austin207/32-bit-Tiny-GPU/assets/PDFs/Core.pdf

Core Module Architecture-level core datapath — SIMT GPU core with replicated thread lanes

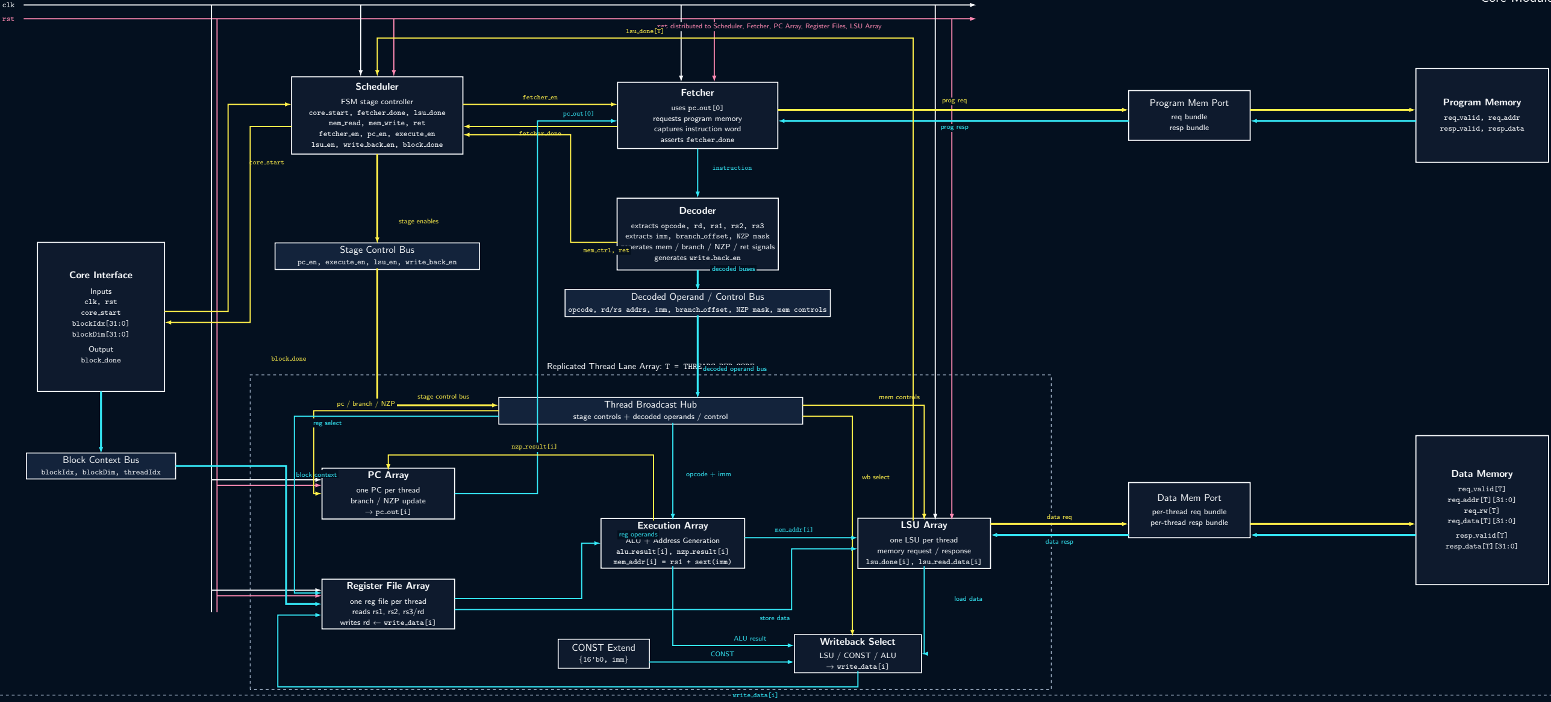
[picture p6: figure]
Core Interface; Inputs; clk, rst; core start; blockIdx[31:0]; blockDim[31:0]; Output; block done; Block Context Bus; blockIdx, blockDim, threadIdx; Program Memory; req valid, req addr; resp valid, resp data; Data Memory; req valid[T]; req addr[T][31:0]; req rw[T]; req data[T][31:0]; resp valid[T]; resp data[T][31:0]; Program Mem Port; req bundle; resp bundle; Data Mem Port; per-thread req bundle; per-thread resp bundle; Scheduler; FSM stage controller; core start, fetcher done, lsu done; mem read, mem write, ret; fetcher en, pc en, execute en; lsu en, write back en, block done; Fetcher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

generates mem / branch / NZP / ret signals

pc en, execute en, lsu en, write back en

opcode, rd/rs addrs, imm, branch offset, NZP mask, mem controls

### Replicated Thread Lane Array: T = THREADS PER CORE

stage controls + decoded operands / control rst distributed to Scheduler, Fetcher, PC Array, Register Files, LSU Array
