austin207/32-bit-Tiny-GPU/assets/PDFs/Memory Controller.pdf

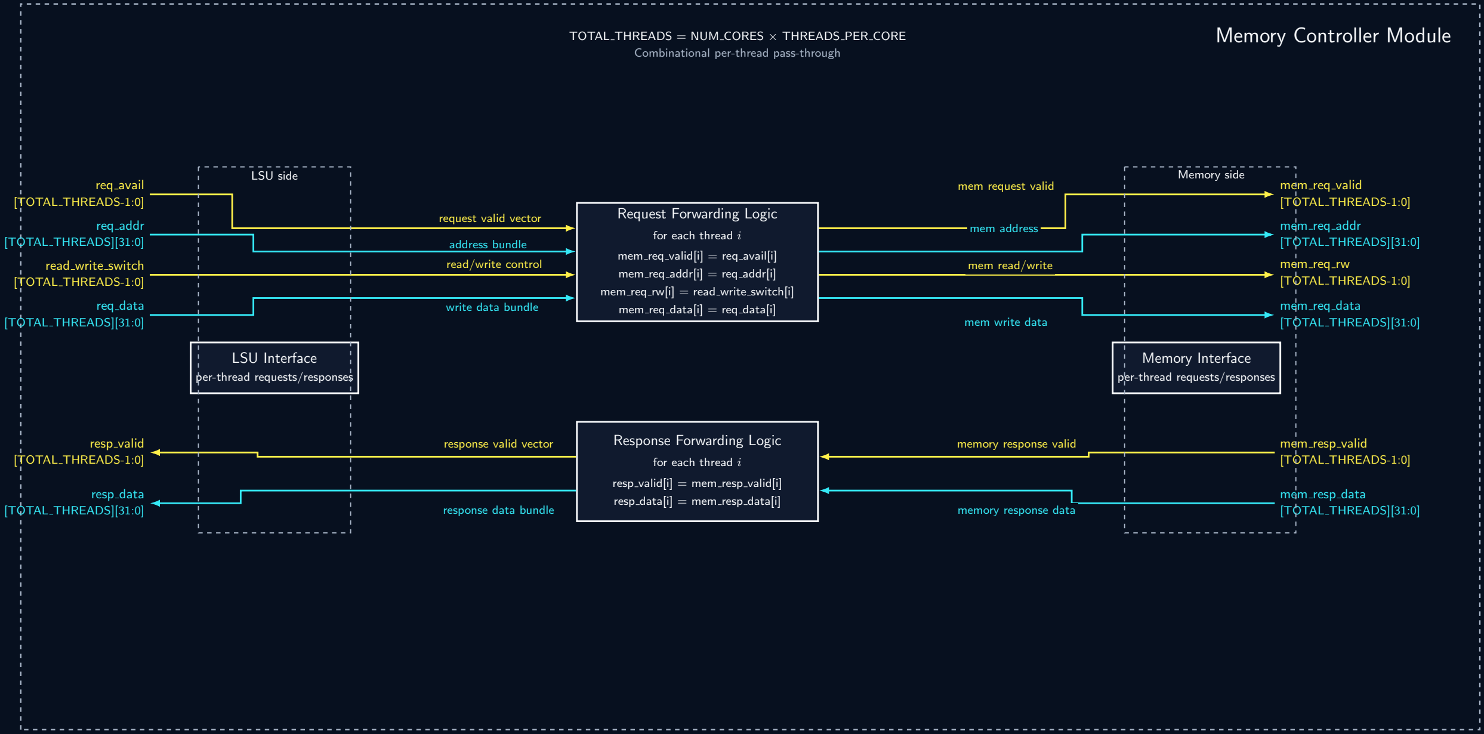
[picture p7: figure]
Combinational per-thread pass-through; Request Forwarding Logic; for each thread i; mem req valid[i] = req avail[i]; mem req addr[i] = req addr[i]; mem req rw[i] = read write switch[i]; mem req data[i] = req data[i]; Response Forwarding Logic; resp valid[i] = mem resp valid[i]; resp data[i] = mem resp data[i]; LSU Interface; per-thread requests/responses; Memory Interface; req avail; [TOTAL THREADS-1:0]; req addr; [TOTAL THREADS][31:0]; read write switch; req data; resp valid; resp data; mem req valid; mem req addr; mem req rw; mem req data; mem resp valid; mem resp data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

TOTAL THREADS = NUM CORES × THREADS PER CORE | Memory Controller Module
