austin207/32-bit-Tiny-GPU/assets/PDFs/DCR.pdf

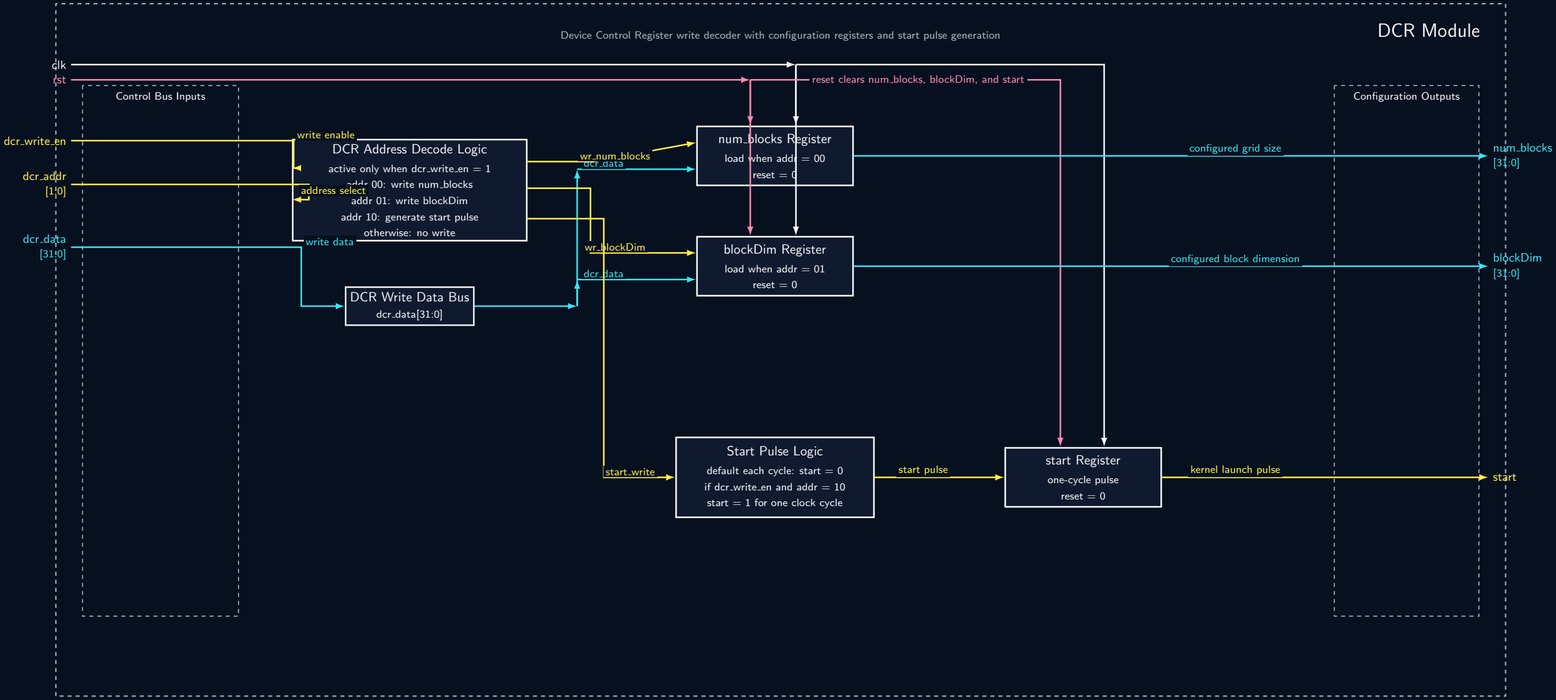
[picture p15: figure]
Control Bus Inputs; Configuration Outputs; clk rst; dcr write en; dcr addr; dcr data; num blocks; blockDim; start; DCR Address Decode Logic; active only when dcr write en = 1; addr 00: write num blocks; addr 01: write blockDim; addr 10: generate start pulse; otherwise: no write; DCR Write Data Bus; dcr data[31:0]; num blocks Register; load when addr = 00; reset = 0; blockDim Register; load when addr = 01; Start Pulse Logic; default each cycle: start = 0; if dcr write en and addr = 10; start = 1 for one clock cycle; start Register; one-cycle pulse; write enable; address select; write data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

Device Control Register write decoder with configuration registers and start pulse generation | DCR Module

reset clears num blocks, blockDim, and start
