austin207/32-bit-Tiny-GPU/assets/PDFs/Dispatcher.pdf

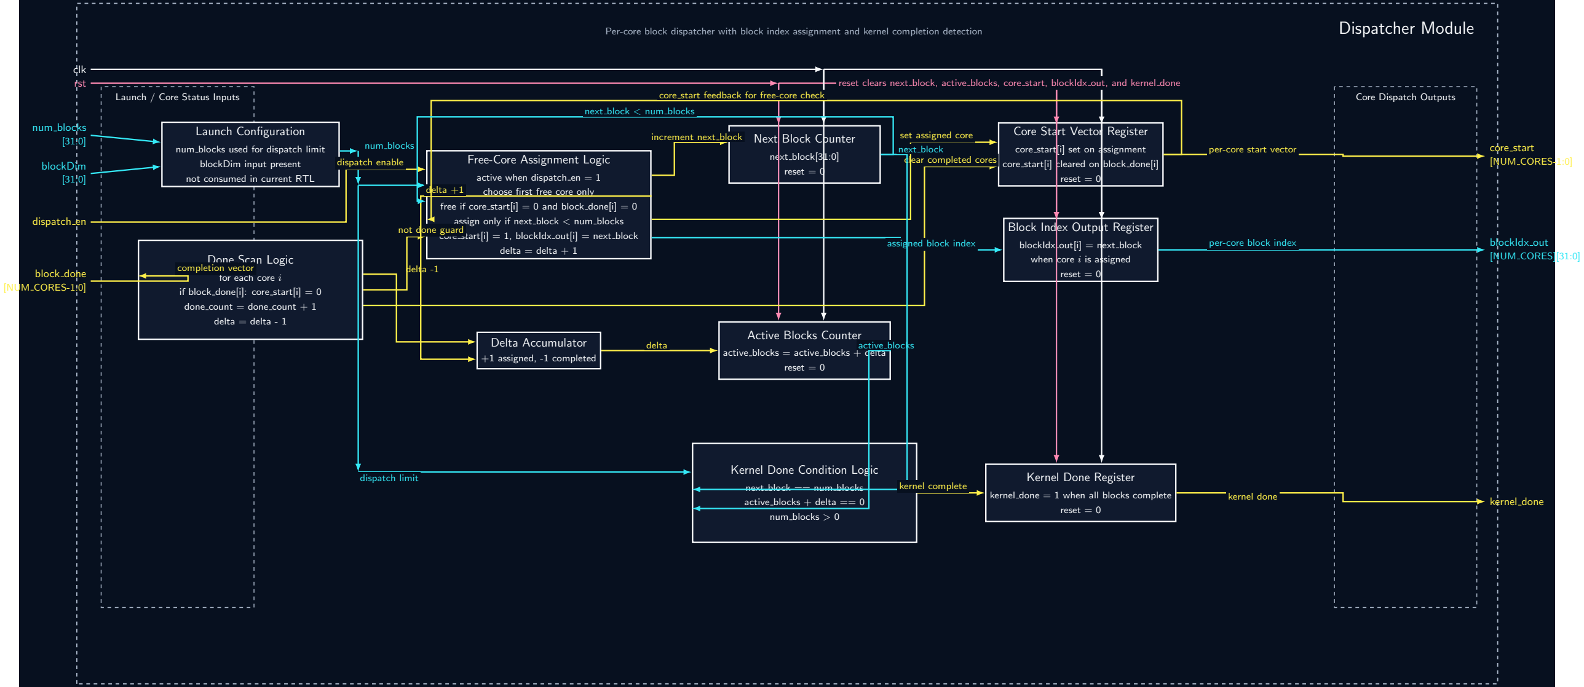
[picture p16: figure]
Launch / Core Status Inputs; Core Dispatch Outputs; clk rst; num blocks; blockDim; dispatch en; block done; [NUM CORES-1:0]; core start; blockIdx out; [NUM CORES][31:0]; kernel done; Launch Configuration; num blocks used for dispatch limit; blockDim input present; not consumed in current RTL; Done Scan Logic; for each core i; if block done[i]: core start[i] = 0; done count = done count + 1; delta = delta - 1; Free-Core Assignment Logic; active when dispatch en = 1; choose first free core only; assign only if next block < num blocks; delta = delta + 1; Delta Accumulator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

Per-core block dispatcher with block index assignment and kernel completion detection | Dispatcher Module

free if core start[i] = 0 and block done[i] = 0

core start[i] = 1, blockIdx out[i] = next block

kernel done = 1 when all blocks complete reset clears next block, active blocks, core start, blockIdx out, and kernel done
