austin207/32-bit-Tiny-GPU/assets/PDFs/Fetcher.pdf

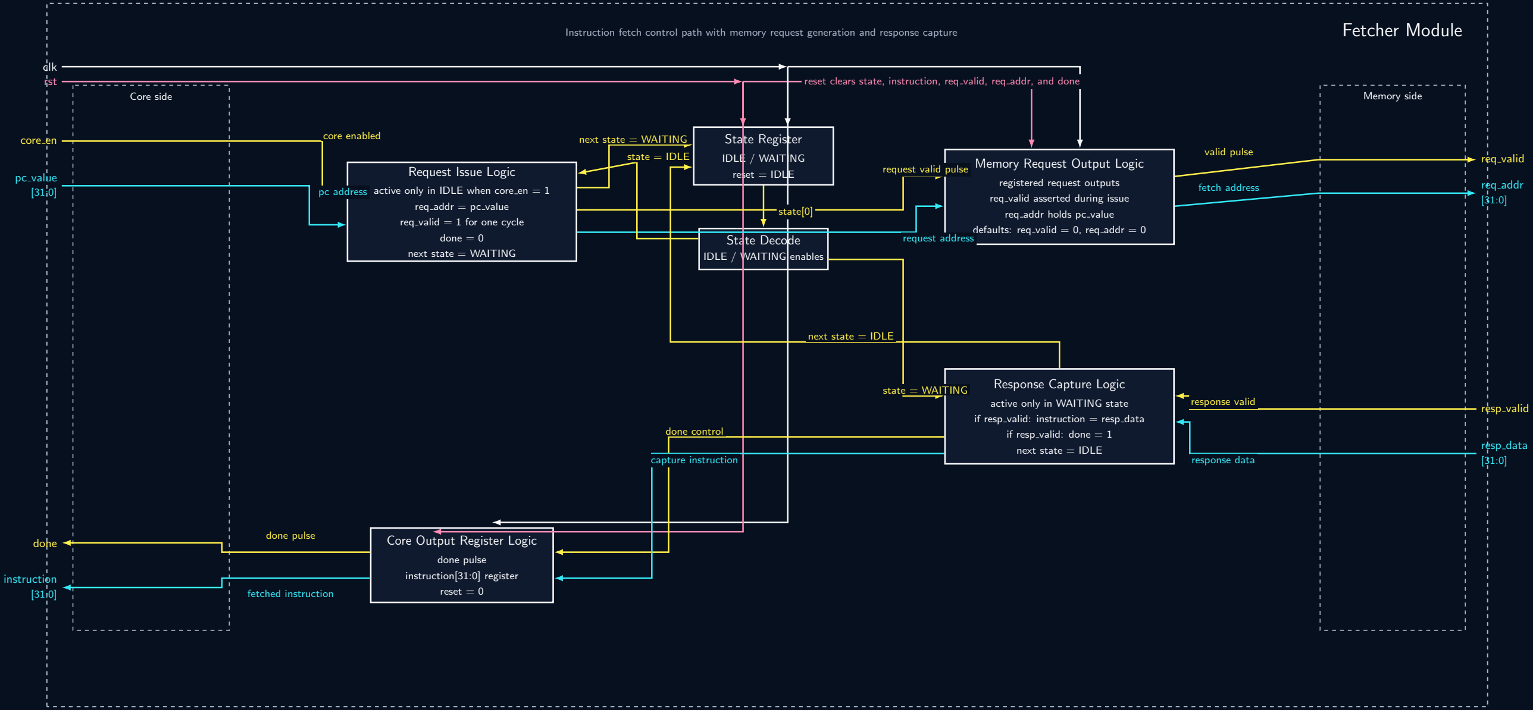
[picture p17: figure]
Core side; Memory side; clk rst; core en; pc value; done; instruction; req valid; req addr; resp valid; resp data; active only in IDLE when core en = 1; State Register; IDLE / WAITING; reset = IDLE; State Decode; enables; Memory Request Output Logic; registered request outputs; req valid asserted during issue; req addr holds pc value; defaults: req valid; = 0, req addr = 0; Response Capture Logic; active only in WAITING state; if resp valid: instruction = resp data; if resp valid: done = 1; next state = IDLE; Core Output Register Logic; done pulse; instruction[31:0] register; reset = 0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

Instruction fetch control path with memory request generation and response capture | Fetcher Module
Request Issue Logic req addr = pc value req valid next state = WAITING | = 1 for one done = 0 | cycle

reset clears state, instruction, req valid, req addr, and done
