austin207/32-bit-Tiny-GPU/assets/PDFs/GPU.pdf

GPU Module Top-level: NUM CORES=4, THREADS PER CORE=4, TOTAL THREADS=16

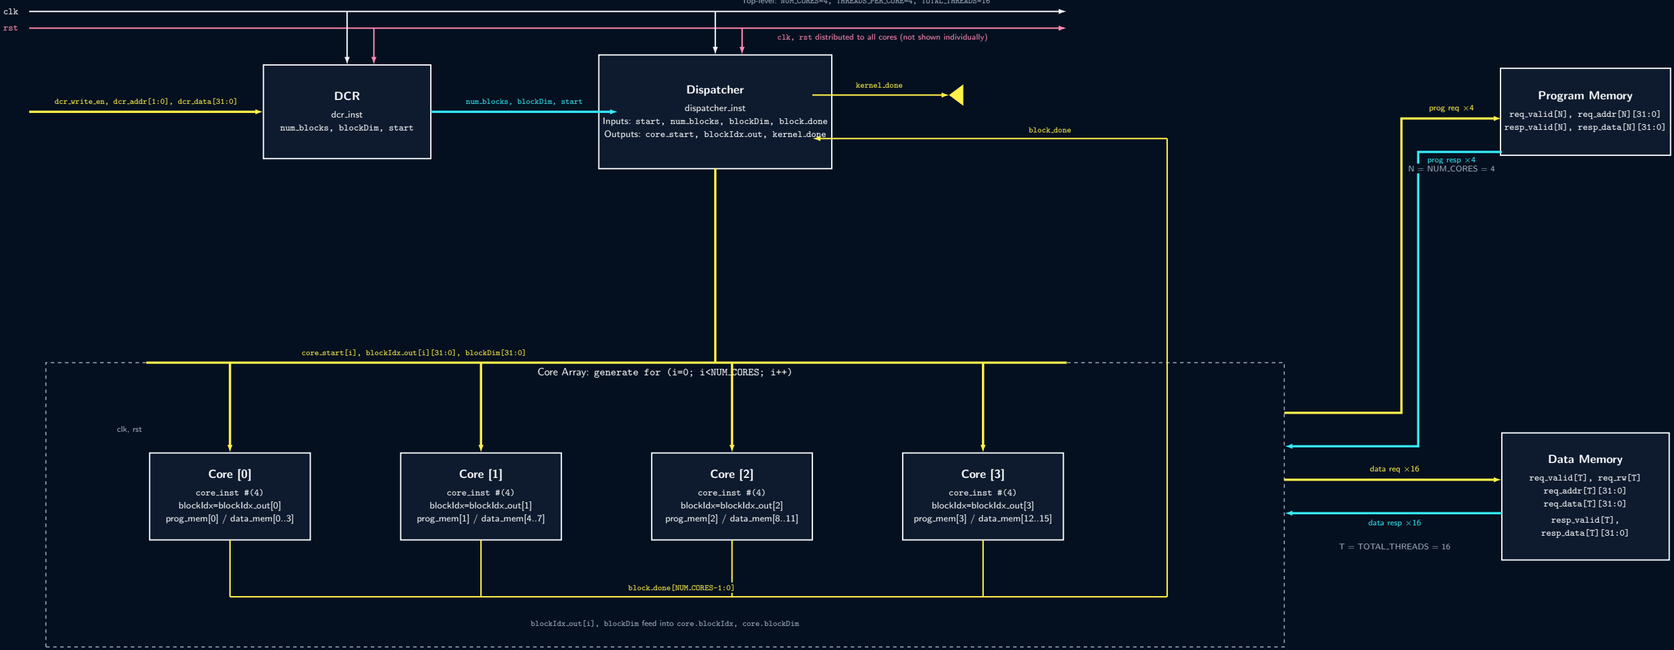
[picture p18: figure]
DCR; dcr inst; num blocks, blockDim, start; Dispatcher; dispatcher inst; Program Memory; req valid[N], req addr[N][31:0]; resp valid[N], resp data[N][31:0]; Data Memory; req valid[T], req rw[T]; req addr[T][31:0]; req data[T][31:0]; resp valid[T],; resp data[T][31:0]; Core [0]; core inst #(4); blockIdx=blockIdx out[0]; prog mem[0] / data mem[0..3]; Core [1]; blockIdx=blockIdx out[1]; prog mem[1] / data mem[4..7]; Core [2]; blockIdx=blockIdx out[2]; prog mem[2] / data mem[8..11]; Core [3]; blockIdx=blockIdx out[3]; prog mem[3] / data mem[12..15]; clk; rst; kernel done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

Inputs: start, num blocks, blockDim, block done Outputs: core start, blockIdx out, kernel done

### Core Array: generate for (i=0; i<NUM CORES; i++)

clk, rst distributed to all cores (not shown individually)

dcr write en, dcr addr[1:0], dcr data[31:0] | num blocks, blockDim, start

blockIdx out[i], blockDim feed into core.blockIdx, core.blockDim
