austin207/32-bit-Tiny-GPU/assets/PDFs/LSU.pdf

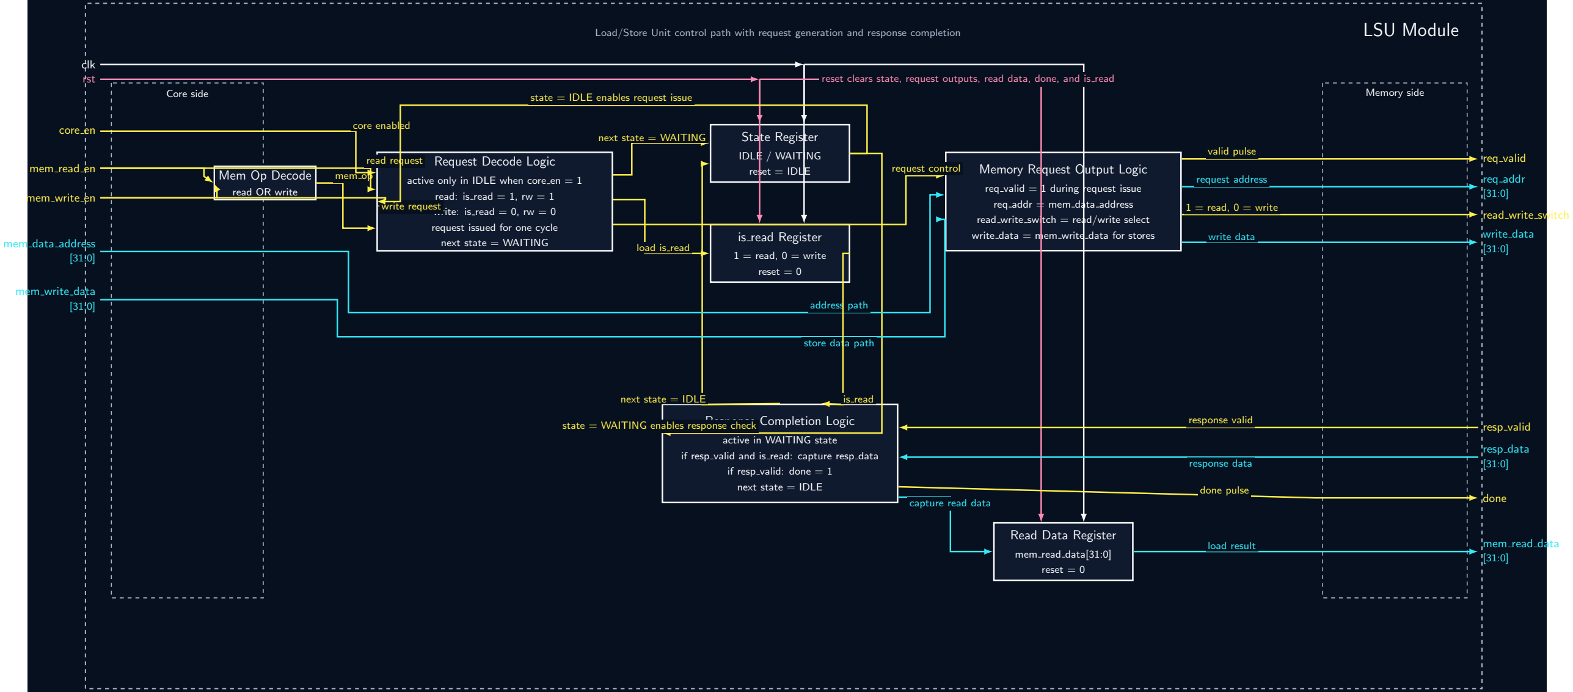
[picture p19: figure]
Core side; Memory side; clk rst; core en; mem read en; mem write en; mem data address; mem write data; req valid; req addr; read write switch; write data; resp valid; resp data; done; mem read data; Mem Op Decode; read OR write; Request Decode Logic; active only in IDLE when core en = 1; read: is read = 1, rw = 1; write: is read = 0, rw = 0; request issued for one cycle; next state = WAITING; State Register; IDLE / WAITING; reset = IDLE; is read Register; 1 = read, 0 = write; reset = 0; Memory Request Output Logic; req valid = 1 during request issue; req addr = mem data address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

Load/Store Unit control path with request generation and response completion | LSU Module

if resp valid and is read: capture resp data reset clears state, request outputs, read data, done, and is read
