austin207/32-bit-Tiny-GPU/assets/PDFs/PC.pdf

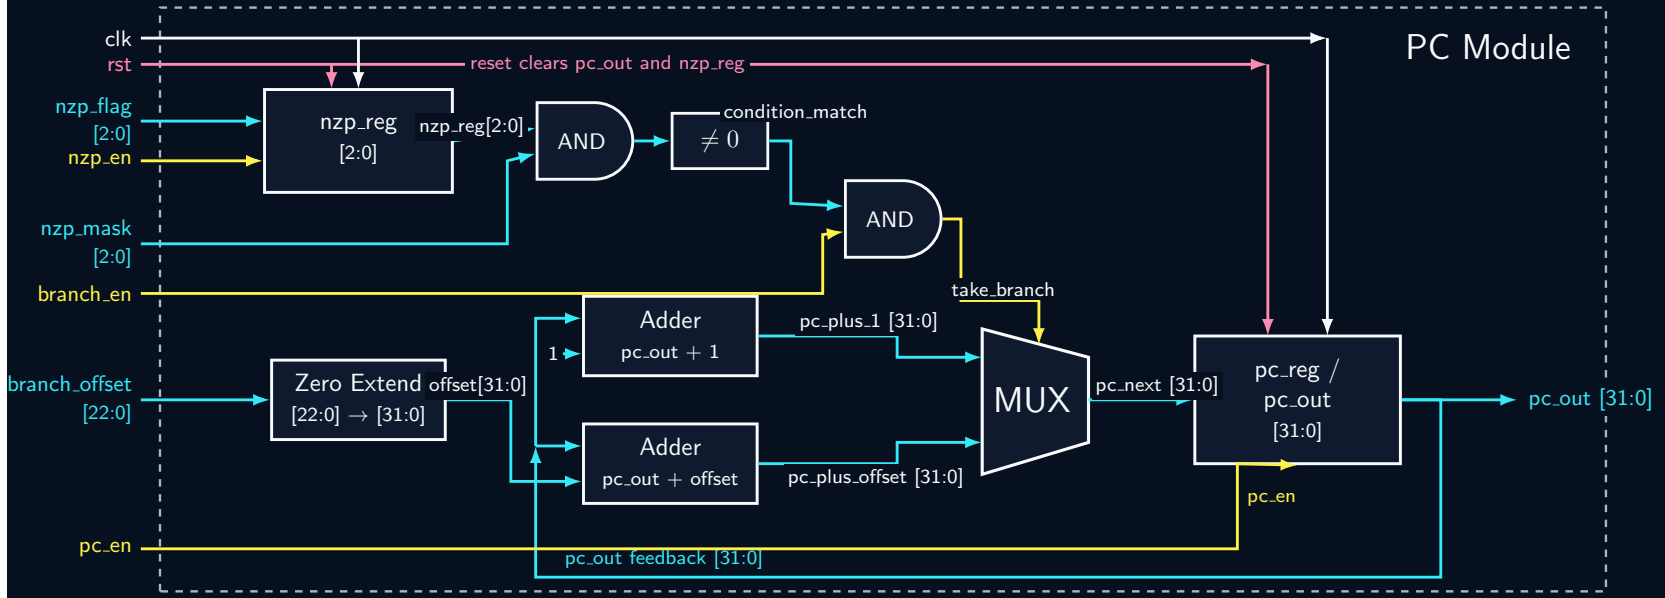
[picture p20: figure]
PC Module clk rst; nzp flag; [2:0] nzp en; nzp mask; branch en; branch offset; nzp reg; AND; Zero Extend; Adder; pc out + 1; pc out + offset; pc reg / pc out; MUX; reset clears pc out and nzp reg; nzp; reg[2:0]; condition match; take branch; offset[31:0]; pc out feedback [31:0]; pc plus 1 [31:0]; pc plus offset [31:0]; pc next [31:0]; pc out [31:0]
