austin207/32-bit-Tiny-GPU/assets/PDFs/Register.pdf

# Registers Module

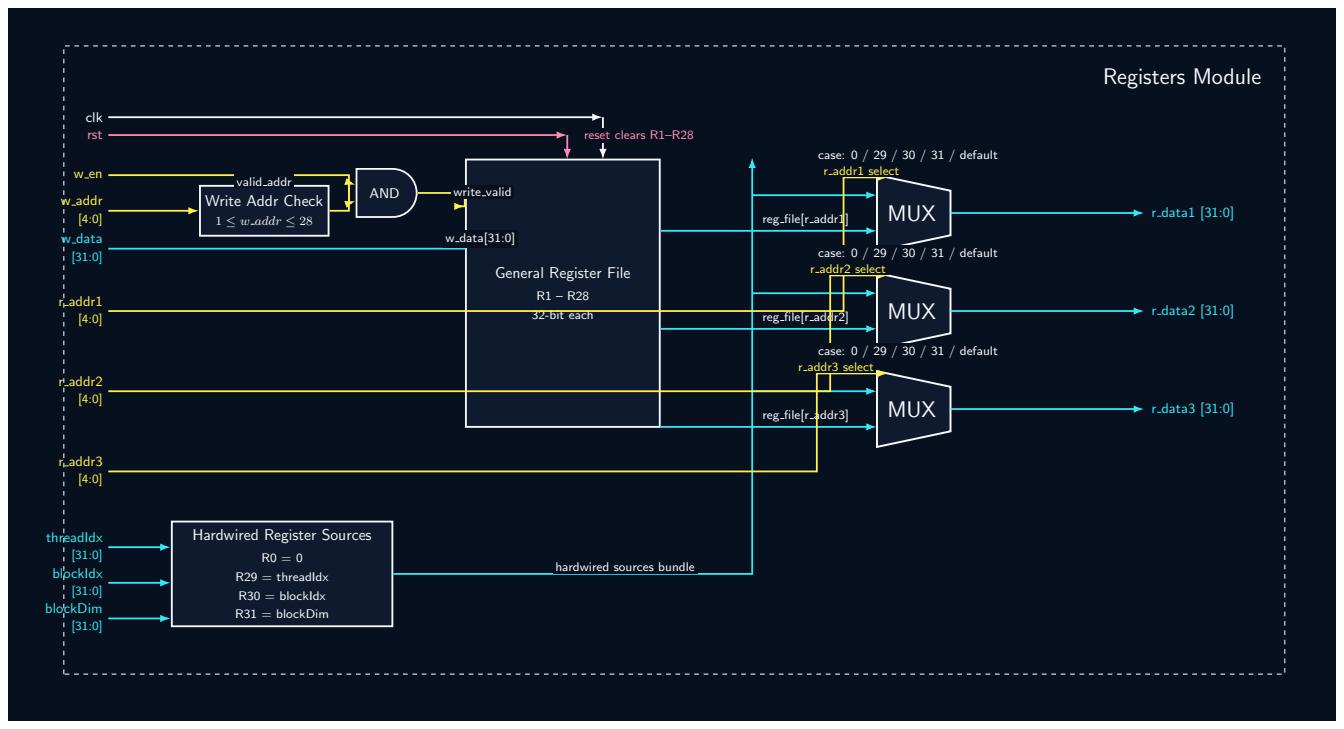
[picture p21: page 1]
clk rst; w addr; w data; addr1; addr2; addr3; threadIdx; [31:0] blockIdx; [31:0] blockDim; AND; R29 = threadIdx; R30 = blockIdx; R31 = blockDim; MUX; reset clears R1–R28; write valid; reg file[r addr1]; reg file[r addr3]; r addr1 select; r addr2 select; r addr3 select; case: 0 / 29 / 30 / 31 / default; r data1 [31:0]; r data2 [31:0]; r data3 [31:0]

valid addr
Write Addr Check
1 ≤ w addr ≤ 28

w data[31:0]

case: 0 / 29 / 30 / 31 / default

General Register File

R1 – R28
32-bit each | reg file[r addr2]

Hardwired Register Sources

hardwired sources bundle
