austin207/32-bit-Tiny-GPU/assets/PDFs/Scheduler.pdf

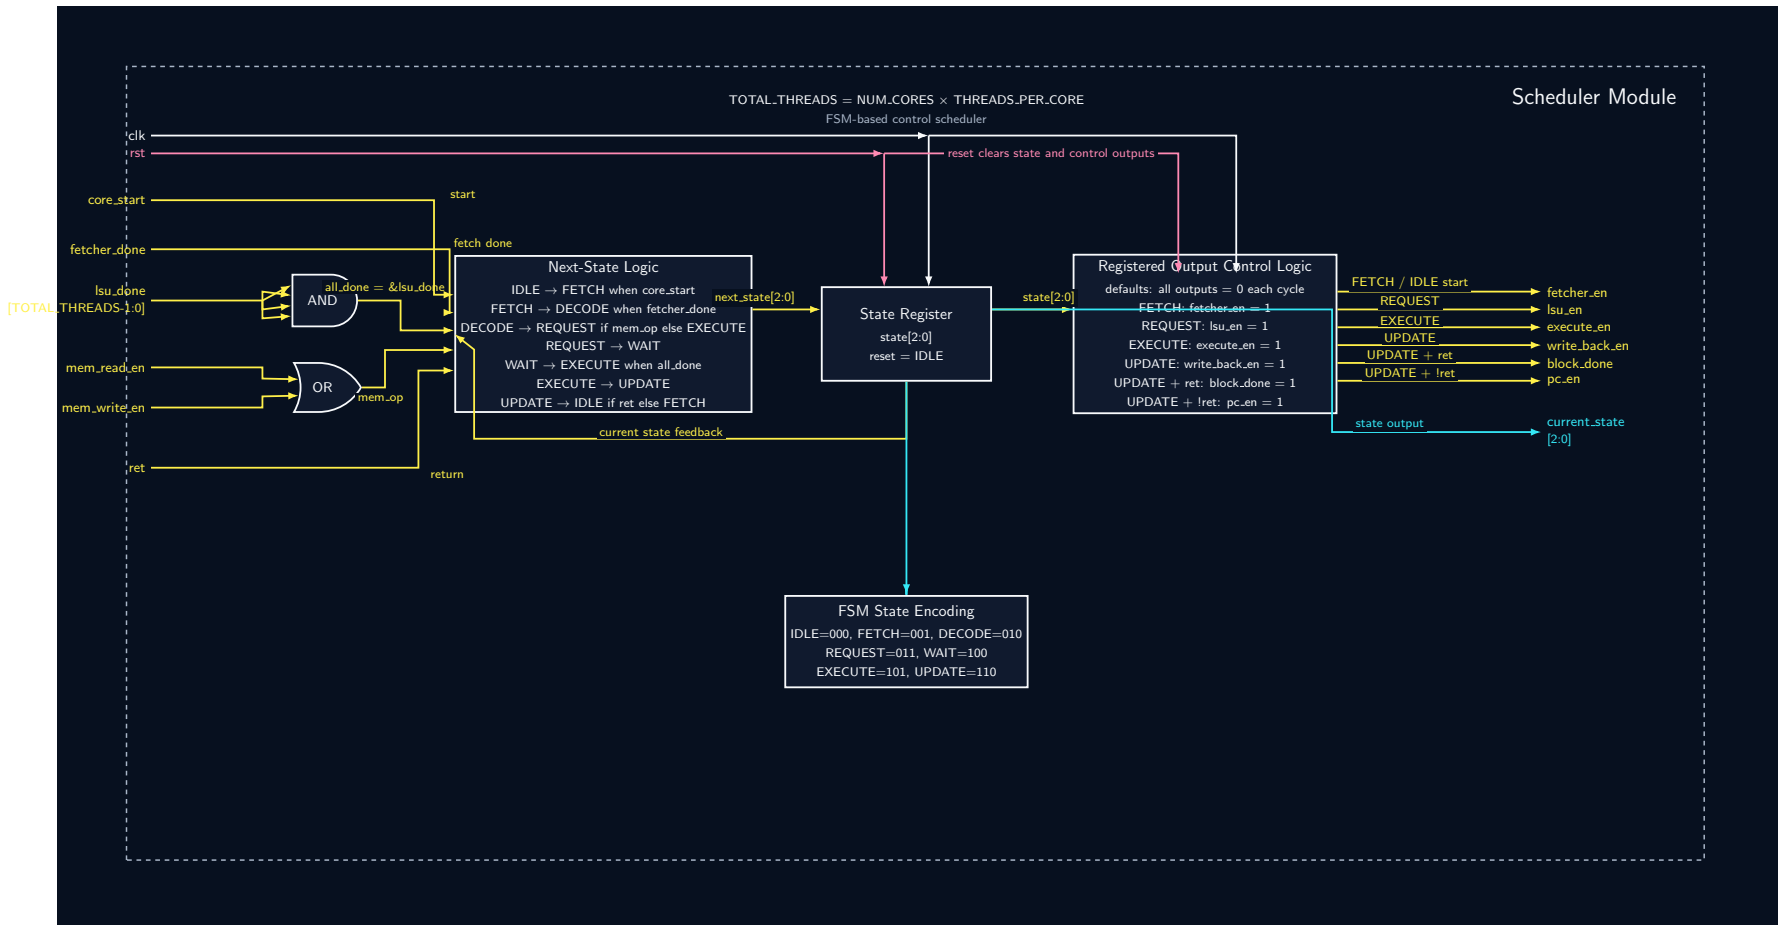
[picture p22: page 1]
TOTAL THREADS = NUM CORES × THREADS PER CORE; Scheduler Module; clk rst; core start; fetcher done; lsu done; [TOTAL THREADS-1:0]; mem read; mem write; ret; REQUEST → WAIT; State Register; state[2:0]; reset = IDLE; REQUEST=011, WAIT=100; EXECUTE=101, UPDATE=110; current state; mem op; start; fetch done; return; next state[2:0]; state output

FSM-based control scheduler

reset clears state and control outputs

Next-State Logic

Registered Output Control Logic

all done = &lsu done
AND

FETCH / IDLE start
REQUEST
EXECUTE
UPDATE
UPDATE + ret
UPDATE + !ret

IDLE → FETCH when core start
FETCH → DECODE when fetcher done
DECODE → REQUEST if mem op else EXECUTE

defaults: all outputs = 0 each cycle

fetcher en
lsu en
execute en
write back en
block done

FETCH: fetcher en = 1
REQUEST: lsu en = 1
EXECUTE: execute en = 1
UPDATE: write back en = 1
UPDATE + ret: block done = 1
UPDATE + !ret: pc en = 1

WAIT → EXECUTE when all done
EXECUTE → UPDATE

UPDATE → IDLE if ret else FETCH

current state feedback

FSM State Encoding

IDLE=000, FETCH=001, DECODE=010
