austin207/32-bit-Tiny-GPU/assets/PDFs/warp_stack.pdf

clk | warp stack Module

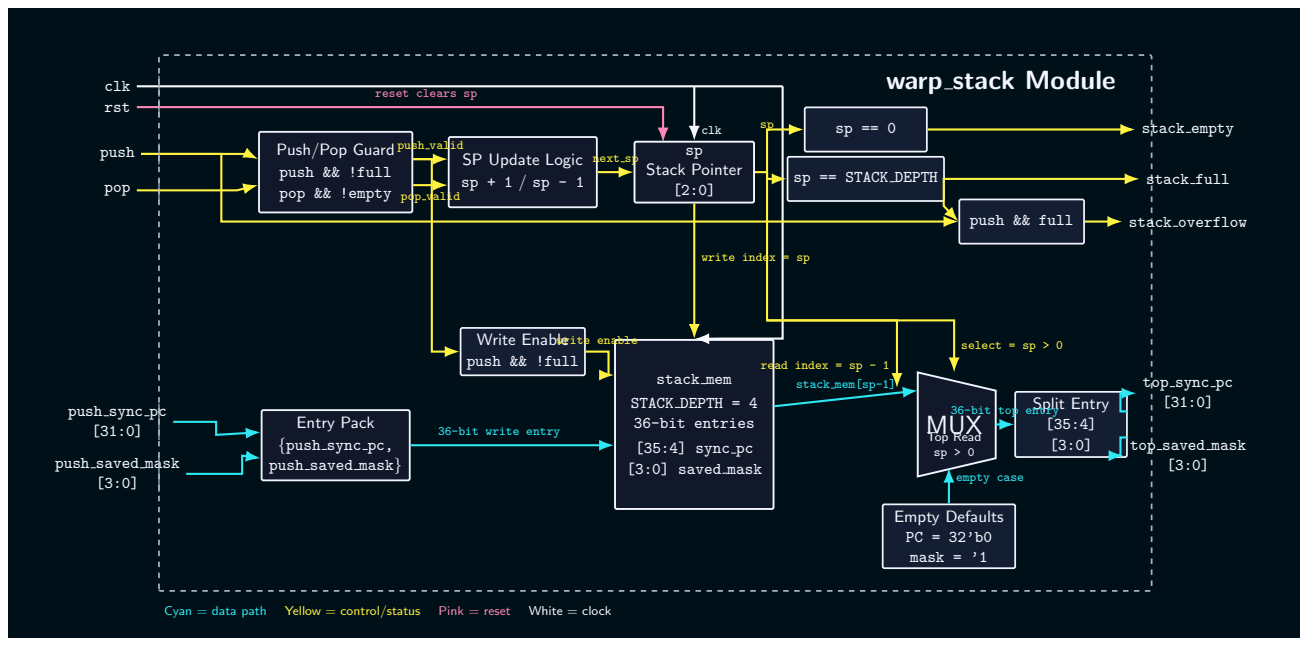
[picture p23: page 1]
rst; push; pop; sp Stack Pointer [2:0]; push && full; Write Enable; push && !full; stack mem; STACK DEPTH = 4 36-bit entries; [35:4] sync pc [3:0] saved mask; Empty Defaults; PC = 32’b0 mask = ’1; Split Entry [35:4] [3:0]; stack empty; stack full; stack overflow; clk; push valid; pop valid; next sp; write enable; select = sp > 0; empty case; Cyan = data path; Yellow = control/status; Pink = reset; White = clock

reset clears sp

Push/Pop Guard
push && !full
pop && !empty

SP Update Logic

sp == STACK DEPTH

write index = sp

read index = sp - 1

top sync pc

stack mem[sp-1]

push sync pc

36-bit top entry
MUX Top Read

Entry Pack
{push sync pc,
push saved mask}

36-bit write entry

top saved mask

push saved mask
