austin207/32-bit-Tiny-GPU/assets/PDFs/ALU.pdf

## 6’h01 ADD op1 + op2

## 6’h02 SUB op1 - op2

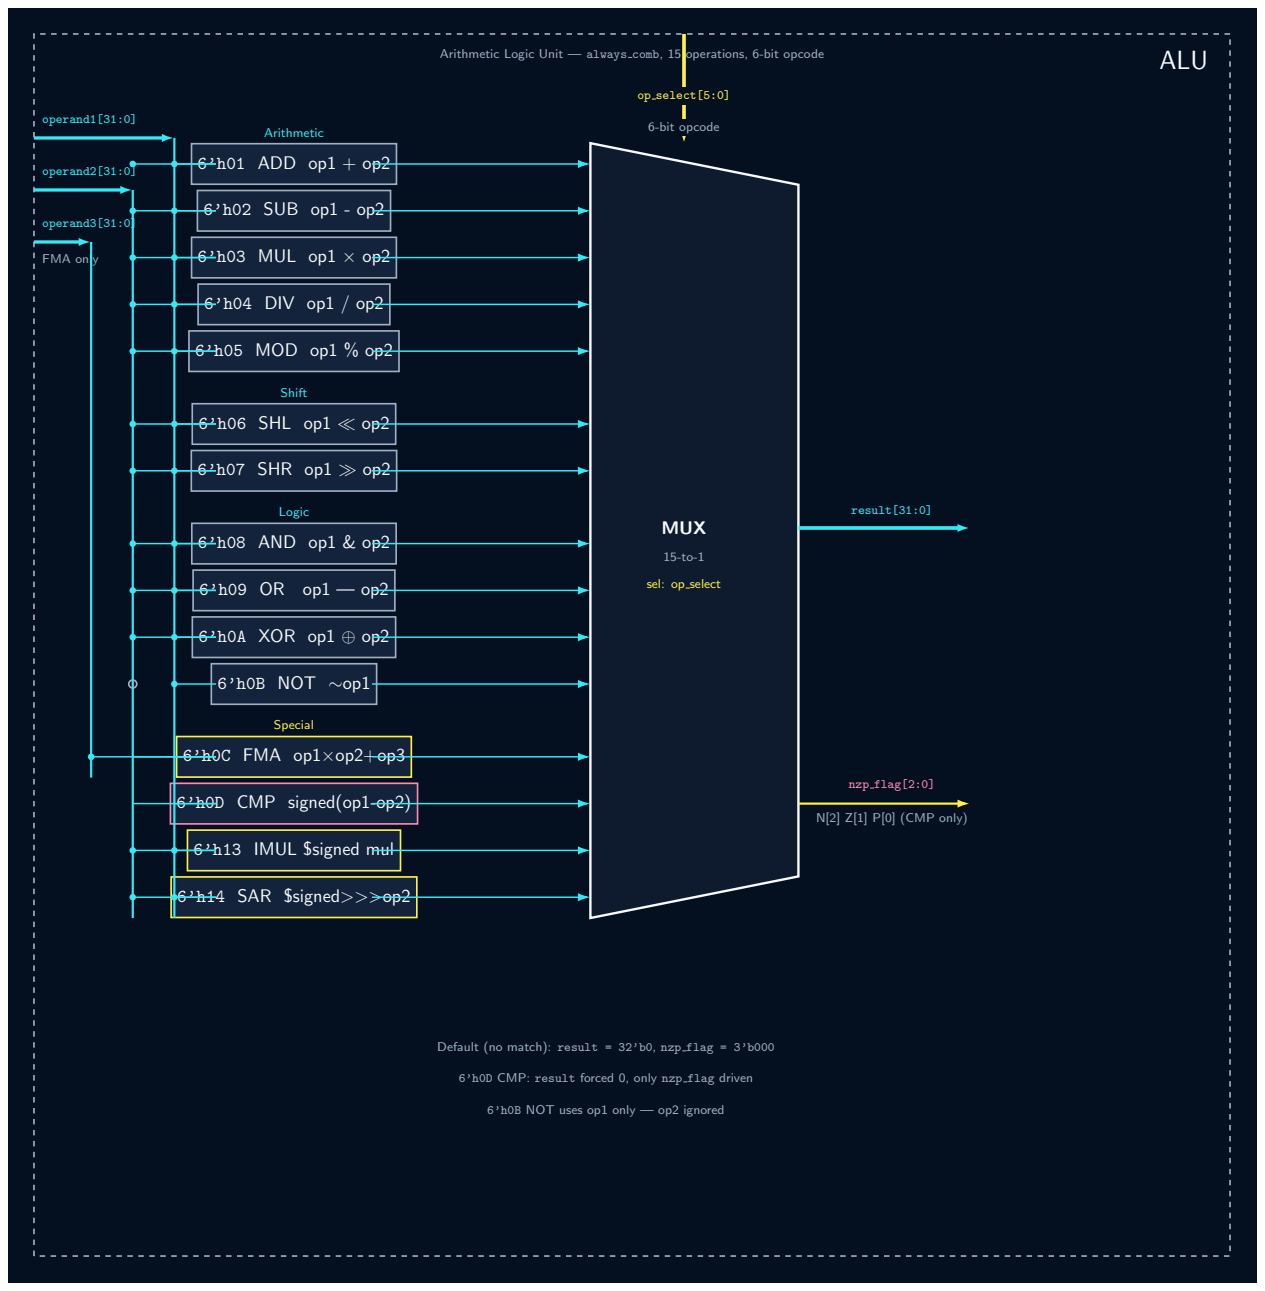
[picture p24: page 1]
ALU Arithmetic Logic Unit — always comb, 15; operations, 6-bit opcode; Arithmetic; 6’h03 MUL op1 × op2; 6’h04 DIV op1 / op2; 6’h05 MOD op1 % op2; Shift; 6’h06 SHL op1 ≪ op2; 6’h07 SHR op1 ≫ op2; Logic; 6’h08 AND op1 & op2; 6’h0A XOR op1 ⊕ op2; 6’h0B NOT ∼op1; Special; 6’h0C FMA op1×op2+op3; 6’h0D CMP signed(op1-op2); 6’h14 SAR $signed>>>op2; MUX; result[31:0]; nzp flag[2:0]; N[2] Z[1] P[0] (CMP only); op select[5:0]; 6-bit opcode operand1[31:0]; operand2[31:0]; operand3[31:0]; FMA only

sel: op select

6’h13 IMUL $signed mul

Default (no match): result = 32’b0, nzp flag = 3’b000

6’h0D CMP: result forced 0, only nzp flag driven

6’h0B NOT uses op1 only — op2 ignored
