austin207/32-bit-Tiny-GPU/assets/PDFs/Decoder.pdf

### ALU Opcode Set

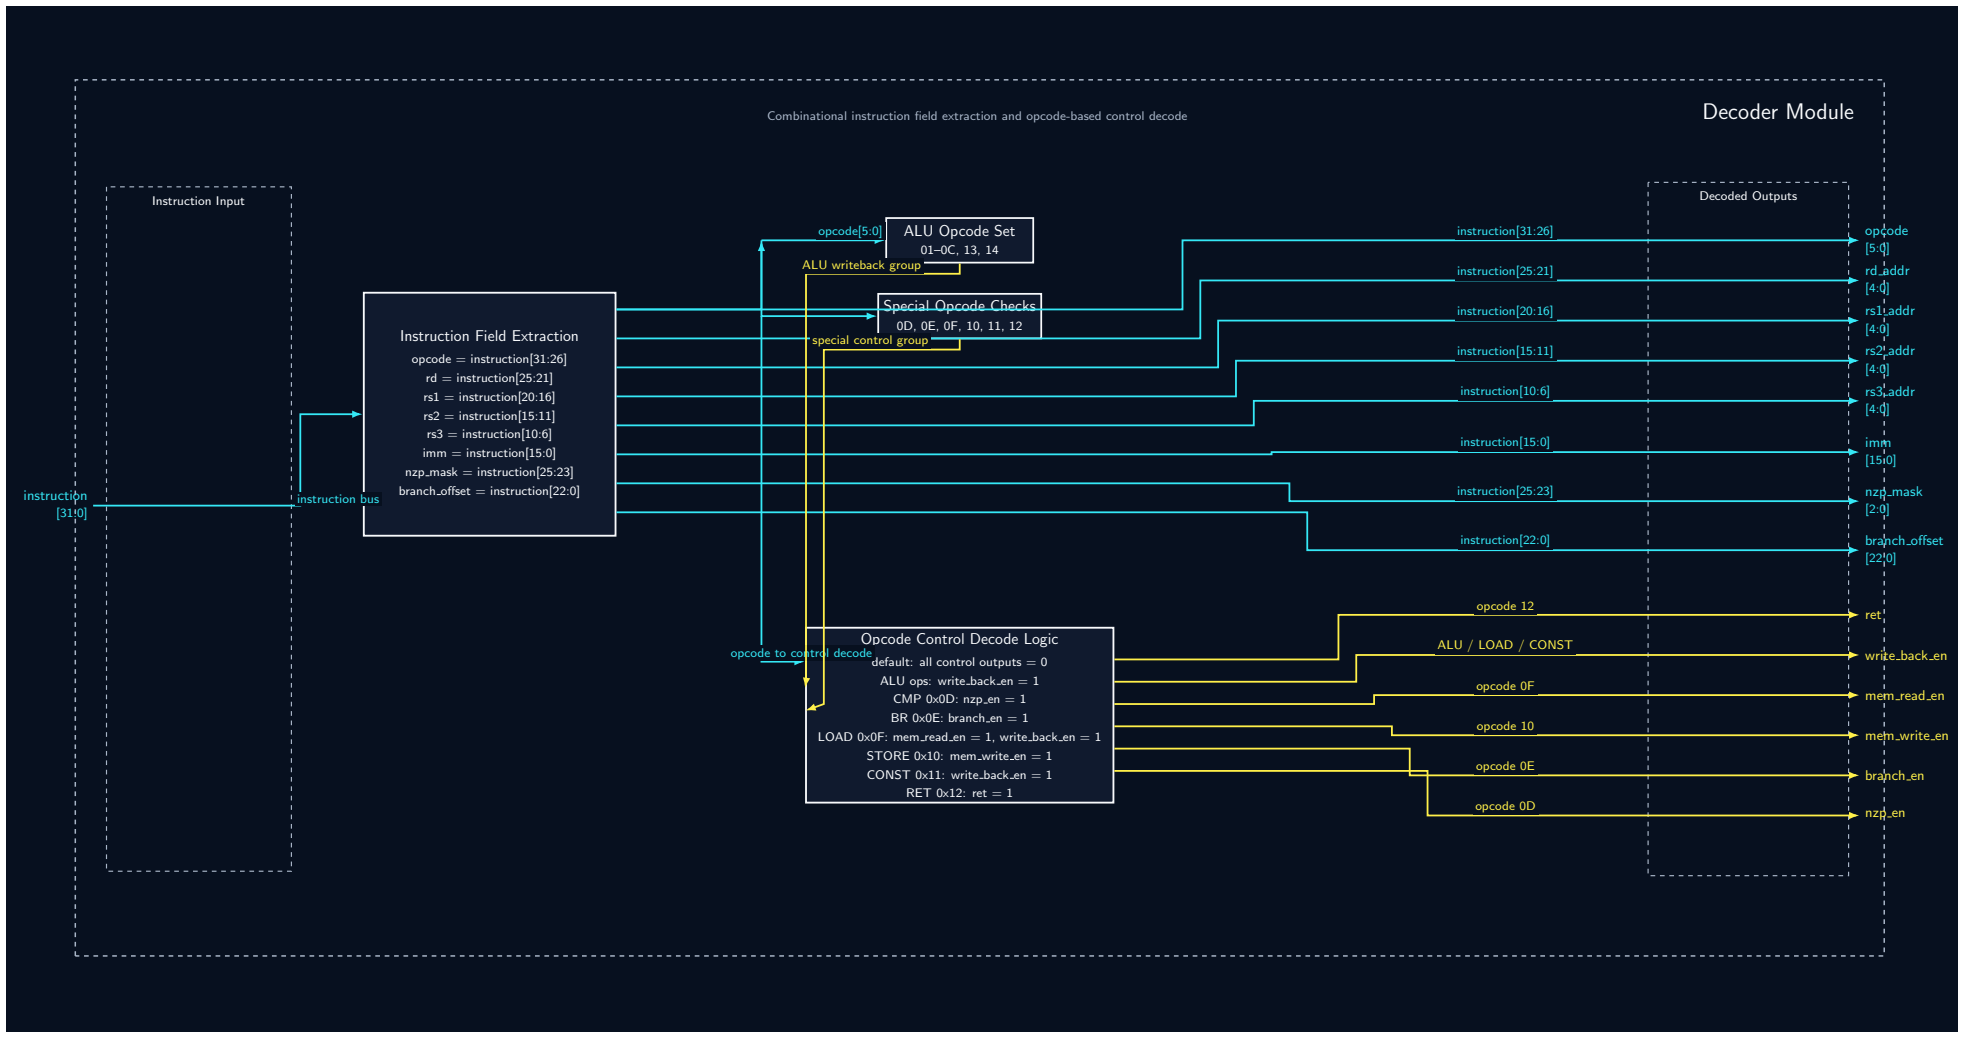
[picture p25: page 1]
Combinational instruction field extraction and opcode-based control decode; Decoder Module; Instruction Input; Decoded Outputs; instruction; opcode; rd addr; addr; imm; nzp mask; branch offset; ret; branch en; nzp en; RET 0x12: ret = 1; opcode[5:0]; instruction[31:26]; instruction[25:21]; instruction[20:16]; instruction[15:11]; instruction[10:6]; instruction[15:0]; instruction[22:0]; opcode 12; opcode 0F; opcode 10; opcode 0E; opcode 0D

ALU writeback group

Special Opcode Checks

Instruction Field Extraction

special control group

opcode = instruction[31:26]
rd = instruction[25:21]
rs1 = instruction[20:16]
rs2 = instruction[15:11]
rs3 = instruction[10:6]
imm = instruction[15:0]
nzp mask = instruction[25:23]
branch offset = instruction[22:0]

instruction bus

instruction[25:23]

Opcode Control Decode Logic

opcode to control decode

ALU / LOAD / CONST

default: all control outputs = 0
ALU ops: write back en = 1
CMP 0x0D: nzp en = 1
BR 0x0E: branch en = 1

write back en

mem read en

LOAD 0x0F: mem read en = 1, write back en = 1

mem write en

STORE 0x10: mem write en = 1
CONST 0x11: write back en = 1
