austin207/32-bit-Tiny-GPU/(commit log)

2026-05-16 Device Control Register module and testbench done
2026-05-16 Top level gpu module and testbench done, and wired everything up
2026-05-17 Assembler Added, minor fixes in dispatcher and scheduler, toplevel gpu testbench updation
2026-05-21 Some major bug fixes
    [dispatcher.sv, test_top_level_gpu.py, top_level_gpu.sv]
2026-05-21 Refactor test_top_level_gpu.py for improved readability and configuration management; add Makefile for assembler build process
2026-05-23 Refactor GPU assembler and add new phases for testing
    - Updated test_top_level_gpu.py to include new phases for weight update and matrix operations.
    - Added new assembly files for phases 1 to 5, including LDR, matmul, ReLU, forward pass, and weight update.
    - Implemented new axel_imul function for integer multiplication in the assembler.
    - Modified core and decoder to support new opcode for integer multiplication.
    - Removed obsolete test_add and vector_add files.
    - Enhanced Makefile to compile and run new phase examples.
2026-05-23 Add SAR (Shift Arithmetic Right) operation and update related components
    - Implemented SAR operation in the ALU (opcode 0x14) to perform arithmetic right shifts.
    - Updated the decoder to recognize the new SAR opcode and enable write-back for it.
    - Modified the assembler to include the SAR operation in the instruction set and corresponding function declarations.
    - Updated the axel_weight_update example to use the new SAR operation instead of SHR for weight updates.
    - Added emission functions for SAR in the GPU assembly code.
2026-05-23 Refactor GPU testbench and inference scripts for Q8 fixed-point operations
    - Updated to implement training with Q8 encoding, including forward and backward passes.
    - Added functions to save and load weights in JSON format.
    - Introduced new inference script to handle model inference using pre-trained weights.
    - Modified assembler files for phase 4 and phase 5 to support Q8 fixed-point arithmetic.
    - Updated hex files for phase 4 forward pass and phase 5 weight update with new instruction sets.
    - Created a new weights.json file to store initial weights for the model.
    [inference.py, test_top_level_gpu.py]
2026-05-23 Schematic Generated
2026-05-23 More Schematic Generated
2026-05-23 Remove obsolete scheduler schematic file to streamline project structure
2026-05-27 Fixed some bugs in the combined verilog code and added drawn assets of the architecture of GPU
    [gpu_combined.v, gpu_fpga_top.sv]
2026-05-27 FPGA files bug fixes
    [gpu_combined.v, gpu_fpga_top.sv]
2026-05-28 Refactor RTL test workflow, enhance Makefile for assembler, and update GPU module with thread_keep_alive logic
2026-05-28 Fixed some minor bugs
    [core.sv, gpu_combined.v, gpu_fpga_top.sv, pc.sv]
2026-05-31 Add Sky130A GDS layout and synthesis reports - 204,938 standard cells, 1.977mm2 chip area - Timing met at ~59MHz on Sky130A 130nm - LVS passed, full GDSII layout via OpenLane 2.3.10 - Synthesized wit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
2026-05-31 Add Sky130A GDS, synthesis reports, and ASIC flow documentation
    - Full GDSII layout via OpenLane 2.3.10 + OpenROAD on Sky130A
    - 204,938 standard cells, 1.977mm2 chip area, ~59MHz
    - LVS passed: 171,278 devices and 171,969 nets matched
    - Documents 3-day flow journey: WSL2 failures, resizer root cause,
    OpenLane 1 segfault, Ubuntu resolution
2026-06-01 Implement SYNC instruction and update related components in core, decoder, and assembler
2026-06-01 Phase 2 Phase A: SIMT per-thread PC, active mask, divergence detection, SYNC ISA
2026-06-01 Warp stacked created and finished
    [core.sv, warp_stack.sv]
2026-06-01 Phase 2 complete: SIMT with per-thread PC, active mask, warp stack, reconvergence
    - SYNC opcode 0x15, BRnzp encoding split (11-bit sync / 12-bit branch)
    - Per-thread PC instantiation with active_pc mux
    - Divergence detection using nzp_stored from pc.sv
    - Warp stack module (depth 4, push/pop/overflow)
    - Scheduler DIVERGE and SYNC_POP states
    - LSU and write_back gated by active_mask
    - lsu_done bypass for masked threads
    - Phase 6 SIMT ReLU kernel: verified T0+T2 keep values, T1+T3 zeroed
    - All 47 tests passing
    [core.sv, pc.sv, scheduler.sv, test_top_level_gpu.py]
2026-06-02 fix(gpu): align packed memory response buses
    Fix the SIMT ReLU LDR writeback failure caused by a packed/unpacked response-data mismatch between the memory controller and core LSU response path.
    - Change mem_controller resp_data to packed [THREADS_PER_CORE-1:0][31:0]
    - Keep core lsu_resp_data packed so response lanes connect cleanly to each LSU
    - Update cocotb memory models to drive packed data_mem_resp_data as a full bus
    - Update memory_controller tests to extract packed response lanes manually
    - Clean temporary SIMT debug probes from top-level GPU tests
    - Add timeout assertion and packed response handling cleanup in inference test
    Verified:
    - memory_controller unit tests pass
    - top-level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
    [core.sv, inference.py, mem_controller.sv, test_top_level_gpu.py, top_level_gpu.sv]
2026-06-02 docs: add complete GPU architecture documentation
    Add focused documentation for the Tiny GPU project, including architecture, ISA, memory map, debug log, AXEL assembler, OpenLane GDS flow, and per-module READMEs. Simplify the root README so it acts as a navigation hub for the detailed documentation.
2026-06-02 docs: add Tiny GPU documentation and schematics
    Add compact root README, architecture/ISA/memory/debug documentation, AXEL assembler docs, FPGA and OpenLane GDS READMEs, and per-module RTL documentation. Organize generated schematic SVGs under schematics/svg and update the schematic generation script/output flow. Refresh FPGA combined Verilog for Gowin usage.
2026-06-02 Combined.v fix for openlane synthesis
    [gpu_combined.v]
2026-06-02 fix(gpu): update data memory and program memory initialization for SIMT GPU
    [gpu_fpga_top.sv]
2026-06-02 Add SIMT GPU GDS — Sky130A, 0 DRC, LVS passed (188,812 devices, 39.1 MHz)
    [metrics_simt.csv]
2026-06-03 Add .axelbin binary format — kernel + data in one file
    - axel.h: add data_mem[256] + data_mem_size to AxelGPU struct
    - axel.c: add axel_set_data(), axel_compile_bin(), fix axel_init() zero-init
    - axelbin.py: Python loader/inspector for .axelbin files (assembler/tools/)
    - All phase examples: emit both .hex and .axelbin per build
    - phase6_simt_relu: embeds input data via axel_set_data (no testbench setup needed)
    - Build outputs separated: builds/hex/ and builds/bin/
    - test_top_level_gpu: test_simt_relu loads from .axelbin, DCR values from header
    - 47/47 tests passing
2026-06-06 feat(trace): add cycle-accurate execution trace logger to test_simt_relu
    Inline trace collection inside kernel wait loop. Captures per-cycle
    scheduler FSM state, active_mask, active_pc, instruction word, and
    warp-stack empty flag for core 0. Writes trace_simt_relu.csv alongside
    the testbench on every SIMT ReLU run. 75 cycles captured on first run.
    [trace_simt_relu.csv]
2026-06-06 feat(perf): add kernel cycle counter to top-level GPU
    32-bit kernel_cycles output port on the gpu module. Counter starts on
    the DCR start pulse and stops when kernel_done asserts. Resets cleanly
    on rst for back-to-back launches. Verified against cocotb trace logger:
    both report 75 cycles for SIMT ReLU, exact match.
    [test_top_level_gpu.py, top_level_gpu.sv]
2026-06-06 perf(sta): add post-route STA scripts and results for SIMT GDS
    TT corner (25C/1.80V): WNS -5.40ns, achievable ~32.9 MHz
    SS corner (100C/1.60V): WNS -28.82ns, achievable ~18.6 MHz
    Critical path: core datapath mux tree through a2111oi_2 + a31oi_2
    Previous mid-PNR estimate of 39.1 MHz superseded by SDF-annotated results.
    False paths: rst port (async), thread_keep_alive port (synthetic).
2026-06-06 docs: update README and gds/README with post-route STA results
    - Frequency corrected from ~39.1 MHz to ~32.9 MHz (TT) / ~18.6 MHz (SS)
    - Post-route STA section added to gds/README with corner comparison table
    - Critical path identified: a2111oi_2 + a31oi_2, ~31ns combinational
    - False paths documented: rst port, thread_keep_alive port
    - Tapeout checklist updated: post-route STA now complete
    - Lesson 7 added: mid-PNR WNS estimates are optimistic
    - Future Work updated: removed completed items, added Phase 1 AI ISA extensions
2026-06-06 feat(isa): add Phase 1 AI instructions — DOT4, RELU, CLAMP, MAX
    New opcodes: DOT4 (0x16), RELU (0x17), CLAMP (0x18), MAX (0x19)
    ALU: packed INT8x4 multiply-accumulate, ReLU, INT8 clamp, signed max
    Decoder: four new opcodes added to write_back_en group
    Assembler: emit_dot/relu/clamp/max in gpu_asm.c, axel_dot/relu/clamp/max in axel.c
    Tests: 20/20 ALU tests passing (14 new, covers accumulation, mixed signs, boundaries)
    DOT4 encodes rs3=rd for correct INT32 accumulation into destination register
    [alu.sv, decoder.sv]
2026-06-06 test(decoder): add Phase 1 AI instruction decoder tests
    DOT4, RELU, CLAMP, MAX decoder tests added (9 total, 4 new).
    Verifies opcode field extraction, rd/rs1/rs2/rs3 addresses,
    and control signal correctness for all four new opcodes.
    Full suite: all modules passing.
2026-06-06 feat(phase1): DOT4 end-to-end kernel verified on GPU pipeline
    phase7_dot4_test.c: AXEL C kernel, 1 block 1 thread
    dot([1,2,3,4],[1,2,3,4]) = 30, verified against Python golden reference
    Full pipeline: fetch, decode, DOT4 ALU, register writeback, STR, memory
    601ns simulation, all 13 modules passing
2026-06-06 feat(assembler): add phase 8 target for MLP inference in Makefile fix(gpu): improve kernel cycle counting logic in top-level GPU module
    [trace_simt_relu.csv]
2026-06-07 docs(debug): add back-to-back LDR stale latch bug and GP-register LDR constraint
    Documents the lsu_done_latch stale state bug that caused the second
    consecutive LDR to exit WAIT early with wrong register data.
    Also documents the unresolved LDR base register constraint:
    R0-R28 unreliable as LDR base in multi-thread SIMT mode.
    Workaround: replicate broadcast data and use THREAD_IDX addressing.
2026-06-07 test(mem): verify and close stale LDR base-register constraint
    Adds phase9 broadcast LDR test confirming R0-R28 base works correctly
    in 4-thread SIMT after the lsu_done_latch fix.
    53/53 tests passing. Constraint removed from docs.
    [test_top_level_gpu.py]
2026-06-07 feat(phase2): multiple Q8/Q6 network configs verified
    Config B: 4-in -> 8-out, 2 blocks, multi-block dispatch correctness
    Config C: 8-in -> 4-out, 2x DOT4 accumulation per thread
    Config D: 4-in -> 4-out, Q6 scale (SAR 6)
    All pass golden reference. Cycle counts: B=132 C=171 D=103.
    [test_top_level_gpu.py]
2026-06-07 test(ai): verify two-pass digit classifier kernels
    Adds Phase 13 hidden-layer and Phase 14 output-layer tests.
    Phase 13 computes hidden activations using packed INT8 DOT4:
    h[20..23] = [42, 37, 0, 6]
    Phase 14 computes output scores using scalar IMUL+ADD:
    y[40..43] = [7, 5, 2, 5]
    argmax = class 0
    Verifies both packed DOT4 and scalar accumulation paths in a two-pass
    classifier pipeline.
2026-06-07 fix(dispatcher): support persistent multi-block dispatch
    Refactors dispatcher to treat dispatch_en as a launch pulse and continue
    issuing blocks internally until all requested blocks complete.
    Fixes Phase 15 true 64-input to 16-hidden classifier hang where only the
    first two blocks launched.
    Updates dispatcher tests for launch-pulse semantics and adds a back-to-back
    kernel launch test. And refactored all top level tests
    [dispatcher.sv]
2026-06-07 Expand memory controller verification and fix round-robin arbitration
    [mem_controller.sv]
2026-07-12 Fix branch-offset sign-extension and axelcc STMT_IF/EXPR_DOT4 bugs
    Root cause (pc.sv): branch_offset was zero-extended instead of
    sign-extended before being added to pc_out, so every backward
    (negative-offset) branch — loop back-edges, MMIO poll loops — computed
    the wrong target PC. Fixed to sign-extend the 12-bit field.
    assembler/examples/phase21_accel_matmul.c: updated the hand-assembled
    poll-loop offset (-3 -> -2) to match the corrected branch semantics
    (target = branch_instruction_pc + offset, no +1/-1 fudge).
    axelcc/src/codegen.c:
    - STMT_IF: else-branch had no instruction to skip the then-body when
    the branch was not taken, so control flow always fell through into
    it and its w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
    [pc.sv]
2026-07-12 Wire axelcc into root build; fix stale branch-offset model in pc random test
    axelcc was completely disconnected from make -C assembler
    make[1]: Entering directory '/home/austi/gpu-project/assembler'
    gcc -Wall -Iinclude examples/phase1_ldr_test.c src/axel.c src/gpu_asm.c -o builds/phase1
    cd builds && ./phase1
    axelbin: wrote bin/phase1_ldr_test.axelbin (4 instructions, 0 data words)
    Phase 1 — LDR test: 4 instructions
    [0] 0x3C3D0000
    [1] 0x04410800
    [2] 0x405D0004
    [3] 0x48000000
    gcc -Wall -Iinclude examples/phase2_matmul.c src/axel.c src/gpu_asm.c -o builds/phase2
    cd builds && ./phase2
    axelbin: wrote bin/phase2_matmul.axelbin (19 instructions, 0 data words)
    Phase 2 — matmul: 19 instru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
2026-08-01 Add sequential-kernel-launch harness infra; update docs for axelcc build fixes
    Generalizes the existing full-DUT-reset relaunch pattern (proven in
    test_phase16_digit64_classifier for .axelbin kernels) into launch_kernel(),
    a common.py helper that takes a plain {addr: word} instructions dict so any
    axelcc-compiled .hex kernel can be launched without going through .axelbin
    loading. Validated with a new 3-stage axelcc kernel chain (test_chain1/2/3)
    that hands off through shared data memory across three independent
    full-reset relaunches: mem[10]=7, mem[11]=14, mem[12]=17, all hardware-
    verified via test_axelcc_chain. This closes the harness gap the roadmap
    listed as blocking Phase 5 transformer/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
2026-08-01 Fix axelcc STMT_IF divergence bug; add DIV/MOD; complete Phase 5.1 attention
    STMT_IF's taken-group landing pad emitted a real SYNC instead of a NOP,
    popping the warp stack twice against warp_stack.sv's single push on
    genuine cross-thread divergence. This silently hijacked every thread's
    PC once active_mask incorrectly went full-mask before the then-body
    executed. No prior test exercised real per-thread divergence (all used
    blockDim=1 or uniform conditions) so this was never caught. Fixed by
    emitting a NOP at the taken-group landing pad; only the true
    reconvergence point still pops.
    Also wires up axelcc's DIV/MOD codegen (hardware ops existed, compiler
    never emitted them) and verifies nested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
2026-08-02 Add axelcc compiler quality pass: golden tests, relu fix, const folding, register reuse
    A research pass found real evidence for four things worth fixing:
    production kernels already using 6/8 available temp registers per
    statement, relu(x) fully parsed/sema-checked but silently unimplemented
    in codegen, zero golden-output tests anywhere despite being an explicit
    roadmap item, and no evidence dead-code elimination or sema's permanent
    variable-register allocation needed touching -- so those two are
    explicitly left alone.
    - axelcc/tests/golden_test.py: pins exact compiled .hex instruction
    sequences for a representative kernel set, wired into root `make test`
    right after the compiler rebuild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
2026-08-02 Add CALL/SRET subroutines (compiler+RTL) and DS-CNN kernel pipeline
    - axelcc: wire CLAMP builtin and blockIdx compiler support (both already
    had hardware/decoder support, just needed compiler-side plumbing).
    - axelcc: add func/CALL/SRET subroutine support -- two-pass backpatching,
    R14-R19 register-window convention for params/return value, sema.c
    rejection of nested calls (never more than one call in flight).
    - RTL: implement CALL/SRET end to end -- new call_stack.sv (per-core LIFO
    of return addresses, user-authored), decoder.sv opcodes 0x1C/0x1D,
    pc.sv's call_en/sret_en priority path (kept separate from branch_en's
    existing nzp-gated jump since CALL can legally be a kernel's fir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
2026-08-02 Fix data-memory address ceiling; verify full DS-CNN chain end-to-end
    top_level_gpu.sv's accel_sel decode used to divert every address >= 0x1F0
    to the matmul accelerator's 16-word ctrl block, capping all kernels to 496
    usable words of data memory. Narrowed the RTL decode to the accelerator's
    real 0x1F0-0x1FF footprint and updated memory_models.py's matching Python
    skip-check (previously its own independent open-ended check, now bounded
    the same way), so addresses >= 0x200 reach real data memory again. Added
    test_dscnn_addrfix_verify.py as a permanent regression guard.
    This unblocked task #25: the full 12-kernel DS-CNN voice-command chain
    (stem conv -> 4x[depthwise+pointwise] -> maxpool -> fc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
    [top_level_gpu.sv]
2026-08-02 Temporarily disable syn_dont_touch on alu/pc/registers for critical-path test
    Experiment for Part 1.5 of the plan (critical-path fix toward the >=500MHz
    goal): comment out syn_dont_touch on alu.sv, pc.sv, and register_file.sv
    (all three carried it) and regenerate fpga/gpu_combined.v via sv2v + the
    DIV/MOD stub patch, to test whether it's blocking Yosys's balancing passes
    and causing the wide-mux-to-compound-gate mapping behind the current
    32.9MHz (TT) critical path. Not a permanent change -- revert with git
    checkout if the OpenLane re-run doesn't confirm the hypothesis.
    [alu.sv, gpu_combined.v, pc.sv, register_file.sv]
